EasySensors/ButtonSizeNode3/schematics/BS3_schematic.pdf

GND C¹ | 100nf
CPU&RADIO | SENSORS

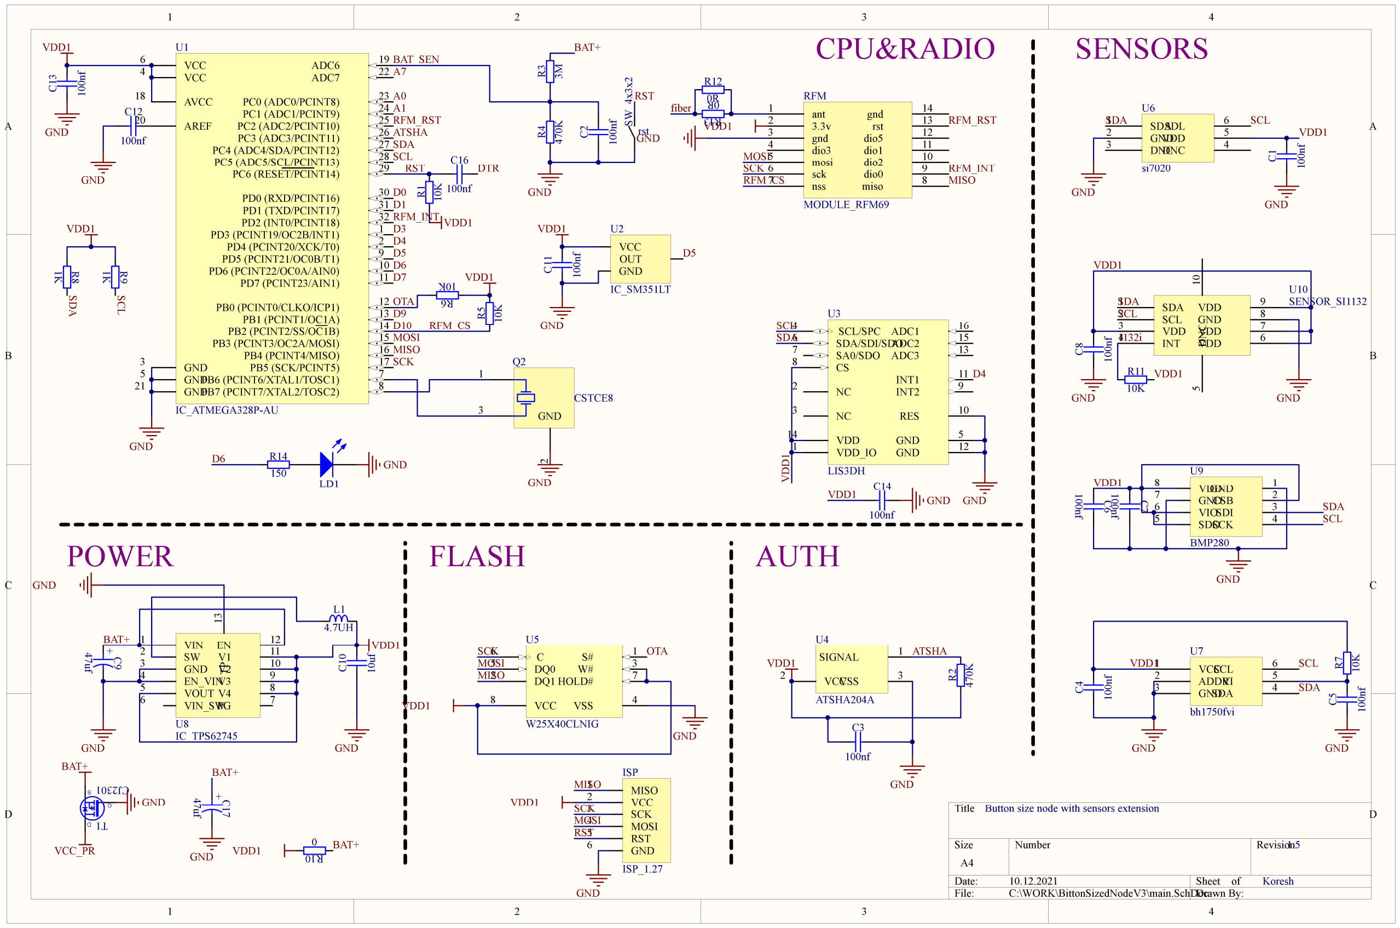
[picture p8: page 1]

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
Title

Size | Number | Revision
A4
Date: | 10.12.2021 | Sheet of
File: | C:\WORK\BittonSizedNodeV3\main.SchDoc Drawn By:

A0
A1

ATSHA

GND

GND

GND

VDD1

RFM_INT

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
MOSI
MISO
SCK

DTR

VDD1

RST

BAT_SEN
A7

C16

100nf

C12

100nf | R¹ 10K C¹³ | 100nf
PC6 (RESET/PCINT14) | 29
PD0 (RXD/PCINT16) | 30
PD1 (TXD/PCINT17) | 31
PD2 (INT0/PCINT18) | 32
PD4 (PCINT20/XCK/T0) | 2

VCC 6

GND 5 | PB6 (PCINT6/XTAL1/TOSC1) | 7
| PB7 (PCINT7/XTAL2/TOSC2) | 8
PD5 (PCINT21/OC0B/T1) | 9
PD6 (PCINT22/OC0A/AIN0) | 10
PD7 (PCINT23/AIN1) | 11
PB0 (PCINT0/CLKO/ICP1) | 12
PB1 (PCINT1/OC1A) | 13
PB2 (PCINT2/SS/OC1B) | 14
PB3 (PCINT3/OC2A/MOSI) | 15
PB4 (PCINT4/MISO) | 16
PB5 (SCK/PCINT5) | 17

AVCC 18

AREF 20

GND 21

PC0 (ADC0/PCINT8) | 23
PC1 (ADC1/PCINT9) | 24
PC2 (ADC2/PCINT10) | 25
PC3 (ADC3/PCINT11) | 26
PC4 (ADC4/SDA/PCINT12) | 27
PC5 (ADC5/SCL/PCINT13) | 28

GND 3

VCC 4

ADC6 | 19
ADC7 | 22
PD3 (PCINT19/OC2B/INT1) | 1

U1

IC_ATMEGA328P-AU

BAT+

GND ⁴⁷uf +C17

1

3 2
GND

Q2

CSTCE8

ATSHA R² 470KVDD1

GND

VCC 2 | VSS | 3
| SIGNAL | 1

U4

ATSHA204A

GND

Koresh

### 1.5 R³ 3M

GND | C² | 100nf R⁴ 470K

VDD1

GND

SCK
MOSI
MISO
OTA S# | 1
DQ1 2 | W# | 3
| VSS | 4

DQ0 5

C

6

HOLD# | 7

VCC 8

U5

W25X40CLNIG | C3

100nf R⁵ 10K

VDD1

VDD1

GND

GND

VDD1 C⁴ | 100nf | C⁵ | 100nf

# GNDR⁷ 10K

SDA 1
SCL 2
VDD 3
INT 4 | DNC

### 5 VDD 6

VDD | 7
GND | 8
VDD | 9 DNC ¹⁰
U10
SENSOR_SI1132 C⁸ 100nf

GND

VDD1

GND 1KR8 | 1KR9

VDD1

1132i

VDD1

BAT+

POWER | FLASH | AUTH

Button size node with sensors extension D

GND

VCC_PR

BAT+

R11
10K
VDD1 C6 100nf | C7 100nf

GND

VDD1 | GND | 1
| CSB | 2
| SDI | 3
SCK | 4 SDO 5

VIO 6

GND 7

VDD 8

U9

BMP280 C¹⁰ | 10uf
GND | GND

L1
4.7UH
VIN | VDD1 1
SW 2
GND 3
EN_VIN 4
VOUT 5
VIN_SW 6 | PG | 7
| V4 | 8
V3 | 9
V2 | 10 V1 | 11 EN | 12 TP ¹³

U8
IC_TPS62745

GND

BAT+

+C9 47uf

VDD1
GND

fiber

MOSI

MISO

SCK
RFM_CS

RFM_RST ant 1
3.3v 2
gnd 3
dio3 4
mosi 5
sck 6
nss
7 | miso | 8
| dio0 | 9
dio2 | 10 dio1 | 11 dio5 | 12 rst | 13 gnd | 14

RFM

MODULE_RFM69

RFM_INT

R12
0R

RFM_CS

RFM_RST

BAT+

VCC

GND

OUT

U2

IC_SM351LT C¹¹ 100nf

GND

VDD1

VDD_IO 1

NC 2

NC 3

SCL/SPC 4

GND | 5

SDA/SDI/SDO 6
SA0/SDO 7
CS 8
INT2 | 9
RES | 10
INT1 | 11
GND | 12
ADC3 | 13

VDD 14

ADC2 | 15 ADC1 | 16

U3

LIS3DH

SCL
SDA

GND

C14

100nf

GND VDD¹

VDD1

MISO 1
VCC 2
SCK 3
MOSI 4
RST 5
GND 6

ISP

ISP_1.27

VDD1

GND

RST

MOSI

SCK

MISO

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
SDA SDA | SCL

D5

D4

SDA 1
GND 2
DNC 3
SDL | 6
VDD | 5
DNC | 4

U6

si7020

VCC 1
ADDR 2
GND 3 | SDA | 4
| DVI | 5
SCL | 6

U7

bh1750fvi

rst SW_4x3x2 RST

LD1

GND D6 | R14
150
