EasySensors/ButtonSizeNode3/pics/enclosure-cr.jpg

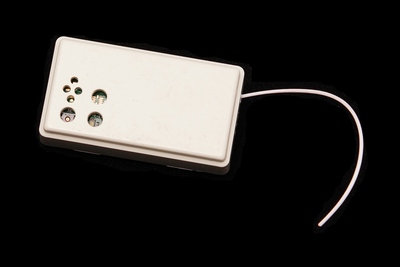
pics/enclosure-cr.jpg
