EasySensors/ButtonSizeNode3/(commit log)

2018-06-21 init BH1750 in ONE_TIME_LOW_RES_MODE
    sends sensor to sleep after each measure is taken
2018-07-09 wait(100) before message send to ensure proper delivery
    this wait(); is RFM69 driver specific. Hope to get rid of it soon
2018-10-06 battery Voltage reporting
    RFM69HW and RFM69CW battery Voltage values defined
2018-12-03 schematics updated
2019-04-04 HCW to CW adapter Gerber files
2019-11-06 code for all the sensors
2020-01-28 battery percentage corrected
2020-01-30 battery reporting updated
2020-12-23 schematics updated v3
2020-12-23 magnet detection added.
    barometric pressure reporting
    magnet sensor reporting added.
2020-12-23 sensor reporting updates
    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
