EasySensors/ButtonSizeNode3/(notices)

Notices in the files:
ButtonSizeNode3LightVersion.ino:
modify it under the terms of the GNU General Public License
